RobbeDierickx/GIP-kruispunt-/Gip tussentijdse voorstelling.pptx

## Gip: stand van zaken

Door: Robbe dierickx

## Doel

- Een werkend kruispunt met een hardwareoplossing, lusdetectie en voetgangersknoppen

## Planning

- Bestellen van de printplaat
- Solderen van de printplaat
- Programmeren van de voetgangersknop
- Programmeren van de lichten
- Programmeren van de lusdetectie

## Milestones

- Lusdetectie Deadline: 16/11/2018 Gehaald
- Vertragingsschema Deadline: 20/11/2018 Gehaald
- Hardware lichtsturing Deadline: 30/11/2018 Gehaald
- Eagle schema en bord Deadline: 11/01/2019 Gehaald

## Al gerealiseerd

- Hardware:
- Lusdetectie
- Vertragingsschema
- Lichtsturing
- Software:
- Frequentieteller

## Blokschema HArdware

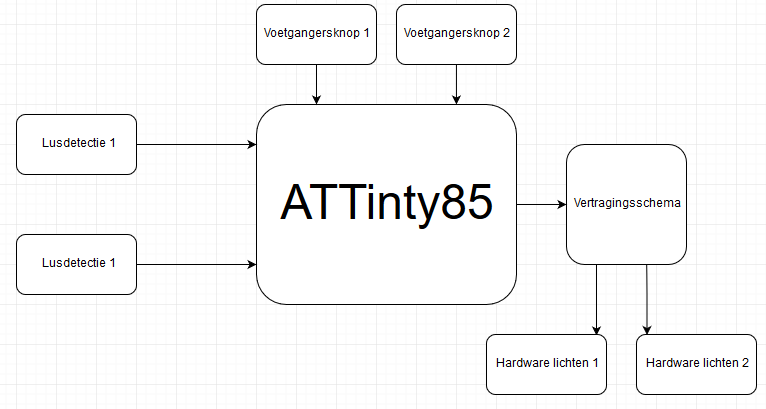
[picture p27: figure]

## Eagle schema’s: Detectielus

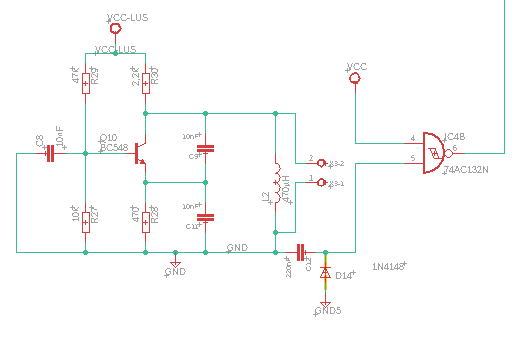
[picture p28: figure]

## Eagle schema’s: Vertragingsschema

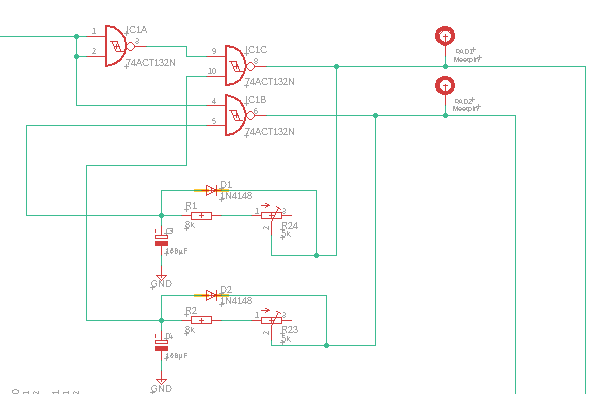
[picture p29: figure]

## Eagle schema’s: Lichtsturing

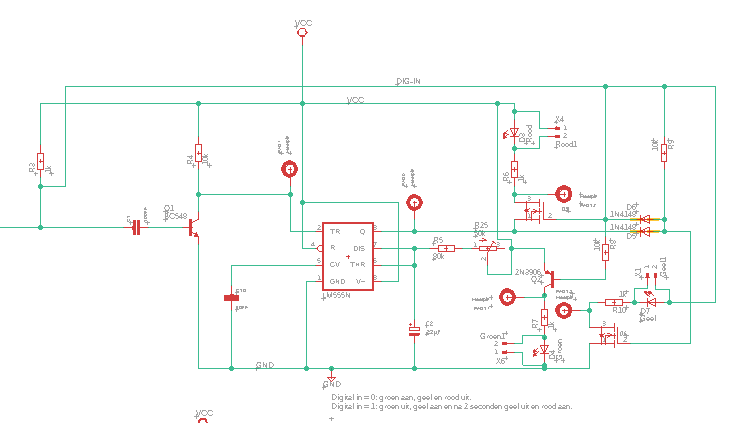
[picture p30: figure]

## Eagle schema’s voeding

Afbeelding met tekst, kaart Beschrijving is gegenereerd met zeer hoge betrouwbaarheid

## Eagle: volledig schema

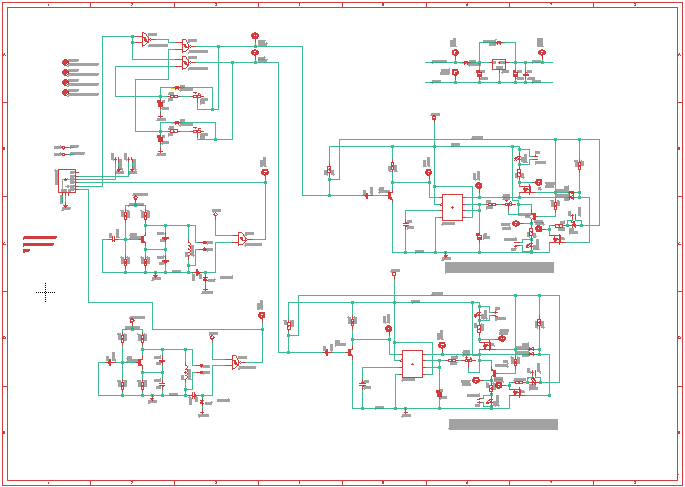
[picture p31: figure]

## Eagle: bord

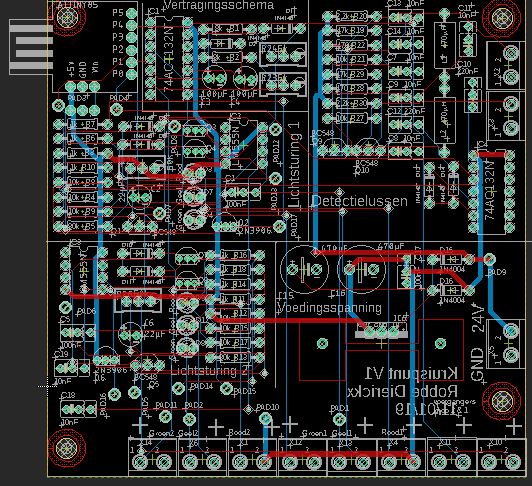
[picture p32: figure]

## Software: flowshart

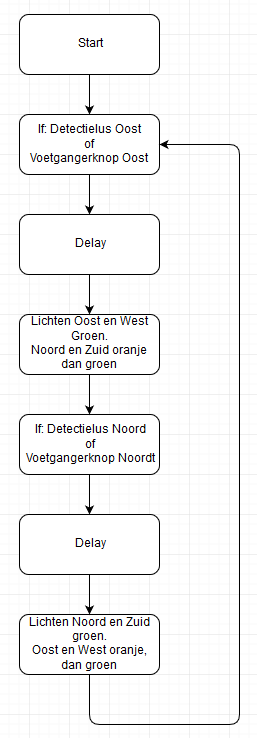
[picture p33: figure]

## Problemen

- ATTiny85: niet genoeg timers om frequentie te meten
- Momentele oplossing: Arduino gebruiken om dan een signaal naar de ATTiny85 te sturen

## Nog te realiseren

- Hardware:
- Printplaat
- Software:
- Lichtsturing
- Voetgangersknoppen

## Conclusies

- Geleerd:
- Lusdetectie
- Wanneer hardware of software te gebruiken
- Eagle te gebruiken
- Verder:
- Printplaat laten maken en hem solderen
- Programmeren van de software (voetgangersknop en lichtsturing)
