RobbeDierickx/GIP-kruispunt-/GIP 6EE Robbe.pptx

## GIP 6EE

Robbe Dierickx

## Wat?

- Automatische regeling van de verkeerslichten op een kruispunt
- Lusdetectie
- Lichtaansturing via hardware
- manuele voetgangersknop

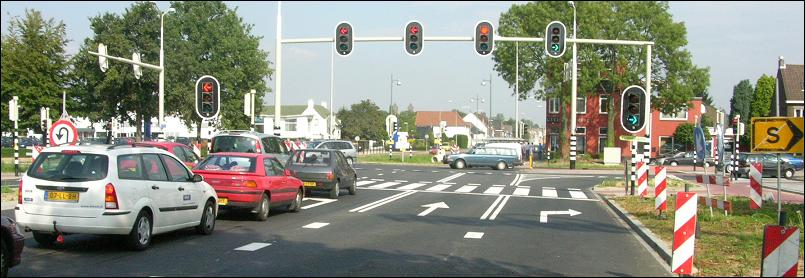
[picture p34: figure]

## Methode

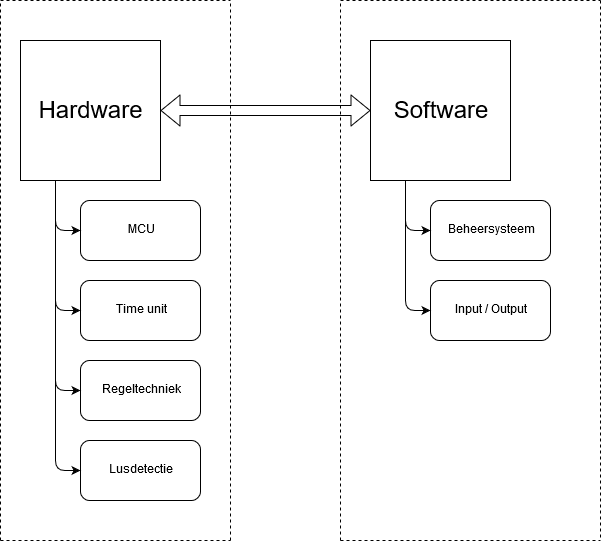
[picture p35: figure]

## Lusdetectie

- Detectie in het wegdek
- voertuig verstoort het magnetische veld Herkend

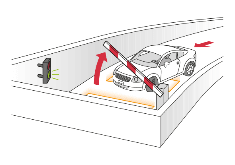
[picture p36: figure]

## MCU

- ATtiny85
- Microcontroller

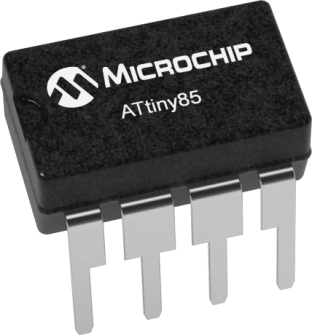
[picture p37: figure]

## Software

- Programmeren met Arduino
- Voetgangersinterface Lichtensturing

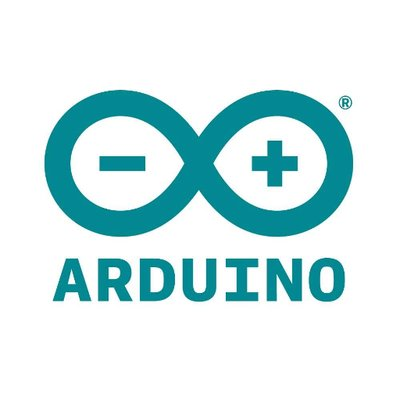
[picture p38: figure]

## Optionele uitbreidingen

- Remote monitoring
- Radar met ultrasoon
- Data doorsturen over Internet Bv: verkeersdrukte
