RobbeDierickx/GIP-kruispunt-/Logboek/Logboek week 21 Robbe Dierickx.docx

# Logboek

## Geïntegreerde Proef

Klas : 6EE

2018-2019

### Technisch adviseur coördinator : M. Van Gucht

Mentor(en) school : E. Arckens

Leerling : Robbe Dierickx

# Logboek

## Geïntegreerde Proef

2018-2019

Naam : Robbe Dierickx

Omschrijving opdracht G.I.P: Kruispunt met behulp van lusdetectie en timers

Betrokken leerkrachten Vak

Mr. E. Arckens Elektriciteit-elektronica

………………………………………………

Mr. E. Arckens Elektriciteit-elektronica

………………………………………………

Schoolweek : 21

Datum | Vak | Omschrijving van de studie, taak of voorbereiding
20/05 | EE | Testen van versie 3 van de printplaat. Aantal gewerkte uren: 2
21/05 | EE | Desolderen en solderen van de definitieve versie van de printplaat. Aantal gewerkte uren: 5
24/05 | EE | Solderen van de nieuwe transistoren + defect component uitzoeken. Aantal gewerkte uren: 2

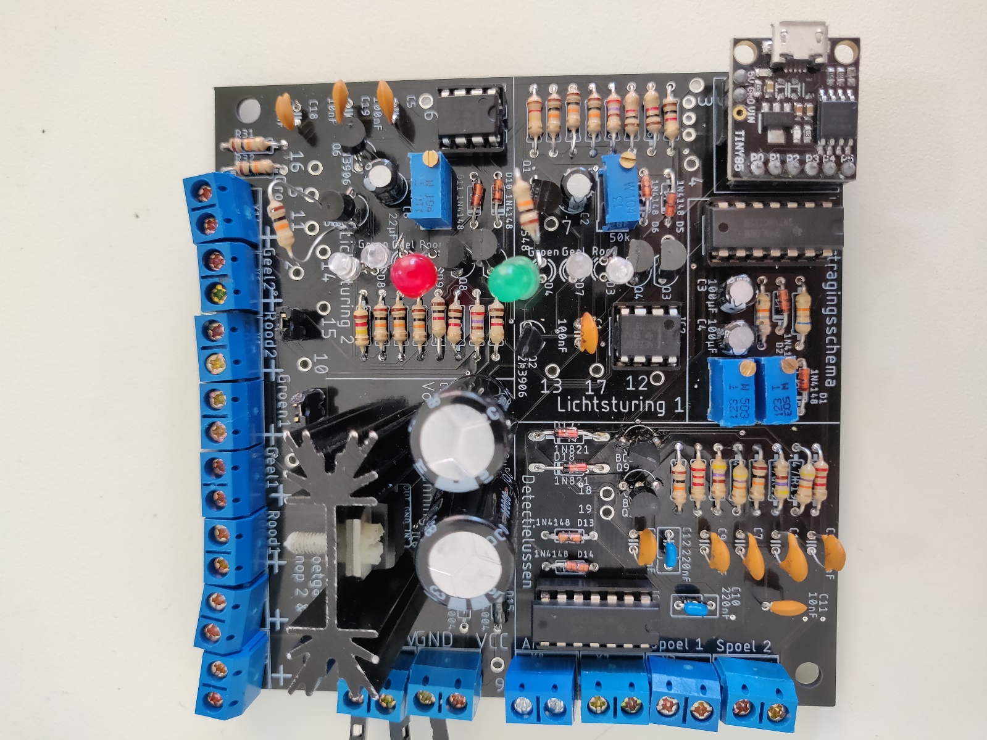
[picture p39: figure]
