RobbeDierickx/GIP-kruispunt-/Logboek/Logboek week 17 Robbe Dierickx.docx

# Logboek

## Geïntegreerde Proef

Klas : 6EE

2018-2019

### Technisch adviseur coördinator : M. Van Gucht

Mentor(en) school : E. Arckens

Leerling : Robbe Dierickx

# Logboek

## Geïntegreerde Proef

2018-2019

Naam : Robbe Dierickx

Omschrijving opdracht G.I.P: Kruispunt met behulp van lusdetectie en timers

Betrokken leerkrachten Vak

Mr. E. Arckens Elektriciteit-elektronica

………………………………………………

Mr. E. Arckens Elektriciteit-elektronica

………………………………………………

Schoolweek : 17

Datum | Vak | Omschrijving van de studie, taak of voorbereiding
23/03 | EE | Maken van versie 3 van de printplaat. Aantal gewerkte uren: 2
25/03 | EE | Afwerken en doorsturen van versie 3 van de printplaat. Aantal gewerkte uren: 2
26/03 | EE | Stijn assisteren met zijn GIP. Aantal gewerkte uren: 3

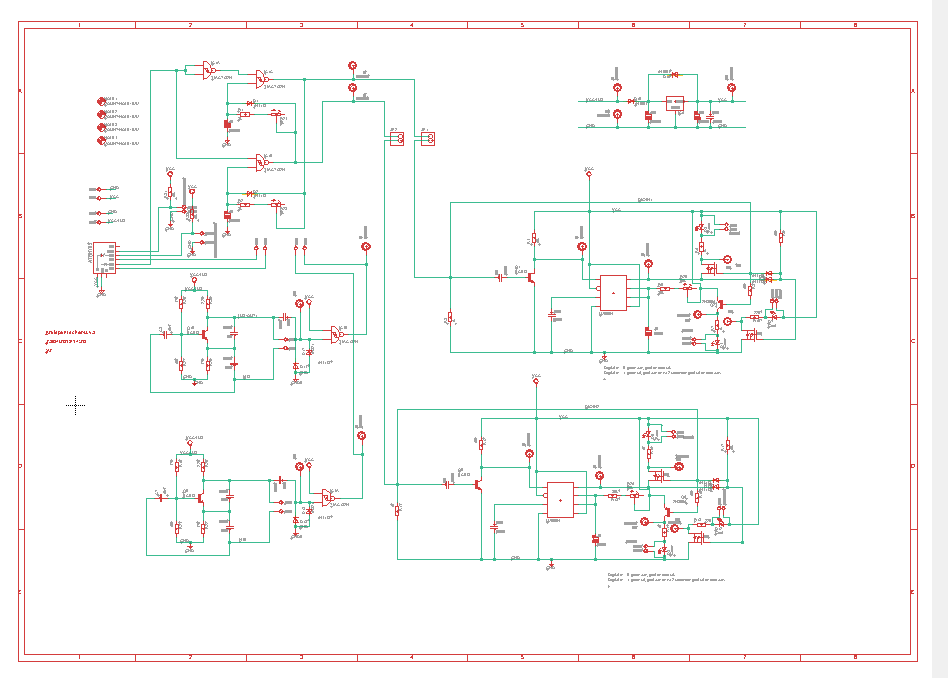
[picture p40: figure]
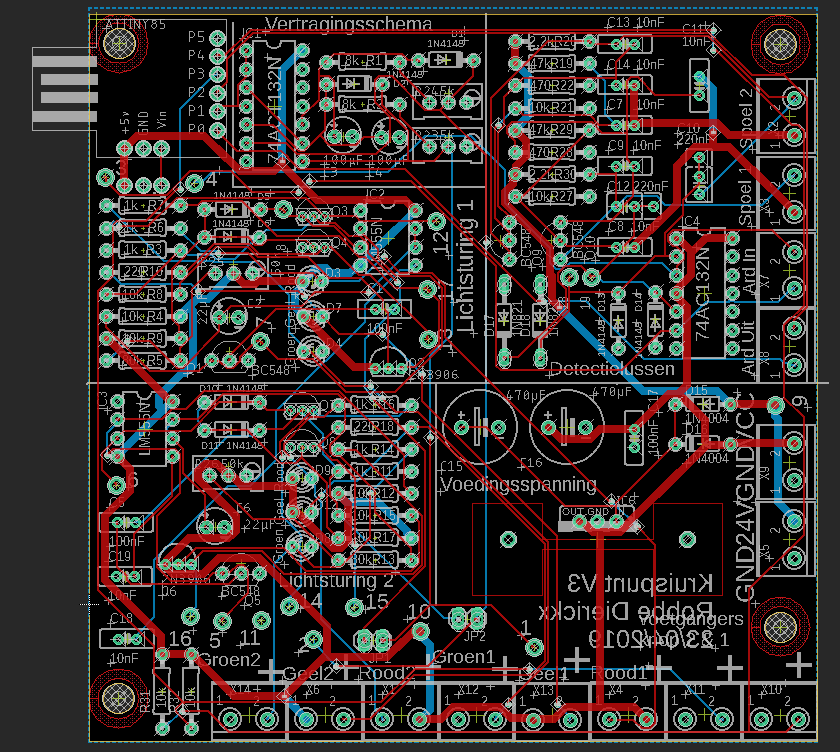
[picture p41: figure]
