RobbeDierickx/GIP-kruispunt-/Logboek/Logboek week 8 Robbe Dierickx.docx

# Logboek

## Geïntegreerde Proef

Klas : 6EE

2018-2019

### Technisch adviseur coördinator : M. Van Gucht

Mentor(en) school : E. Arckens

Leerling : Robbe Dierickx

# Logboek

## Geïntegreerde Proef

2018-2019

Naam : Robbe Dierickx

Omschrijving opdracht G.I.P: Kruispunt met behulp van lusdetectie en timers

Betrokken leerkrachten Vak

Mr. E. Arckens Elektriciteit-elektronica

………………………………………………

Mr. E. Arckens Elektriciteit-elektronica

………………………………………………

Schoolweek : 8

Datum | Vak | Omschrijving van de studie, taak of voorbereiding
19/02 | EE | Verder testen van de colpittsoscillator + testen van het programma: Lusdetectie + versie 2 van de printplaat aanpassen. Aantal gewerkte uren: 3
21/02 | EE | Opstellen van de Demo van de lusdetectie voor de jury + verder aanpassen van Versie 2 van de printplaat. Aantal gewerkte uren: 3
22/02 | | Afwerken van versie 2 van de printplaat en omzetten in gerber files + opzoeken om de frequentie te meten met een ESP8266. Aantal gewerkte uren: 4

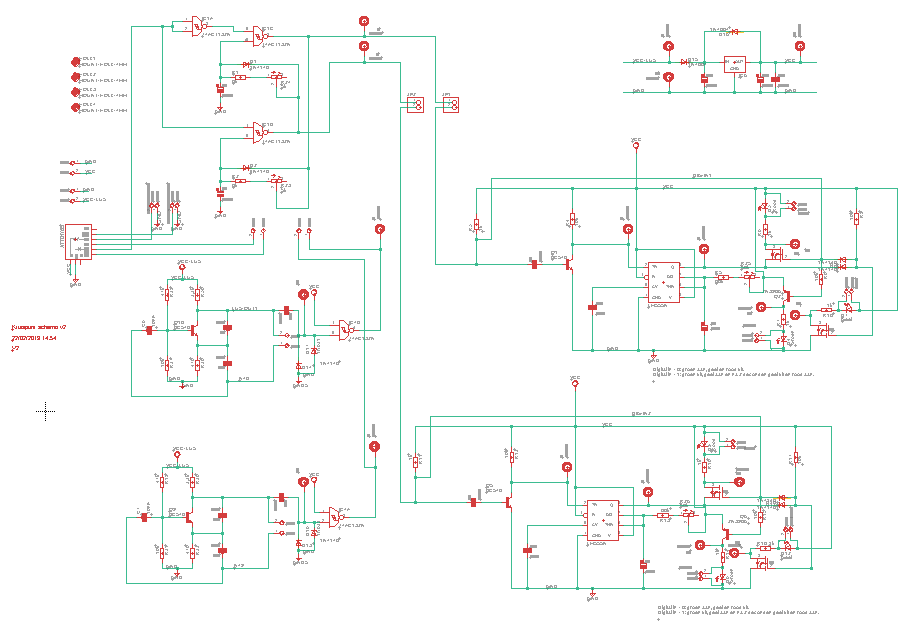
[picture p42: figure]
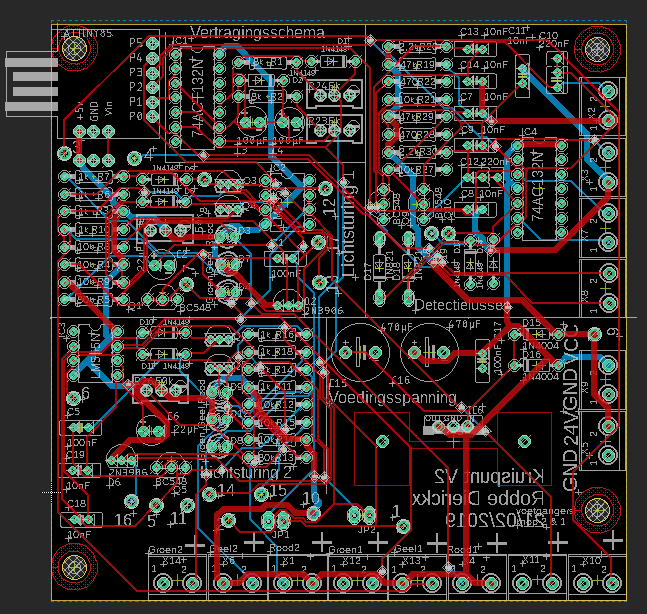
[picture p43: figure]
