RobbeDierickx/GIP-kruispunt-/Logboek/Logboek week 1 & 2 Robbe Dierickx.docx

# Logboek

## Geïntegreerde Proef

Klas : 6EE

2018-2019

### Technisch adviseur coördinator : M. Van Gucht

Mentor(en) school : E. Arckens

Leerling : Robbe Dierickx

# Logboek

## Geïntegreerde Proef

2016-2017

Naam : Robbe Dierickx

Omschrijving opdracht G.I.P: Kruispunt met behulp van lusdetectie en timers

Betrokken leerkrachten Vak

Mr. E. Arckens Elektriciteit-elektronica

………………………………………………

Mr. E. Arckens Elektriciteit-elektronica

………………………………………………

Schoolweek : 1 & 2

Datum | Vak | Omschrijving van de studie, taak of voorbereiding
5/01 | EE | Aanpassen van het schema en bord. Aantal gewerkte uren: 2
11/01 | EE | Verder aanpassen van het schema en bord + exporteren naar een gerber file. Aantal gewerkte uren: 3

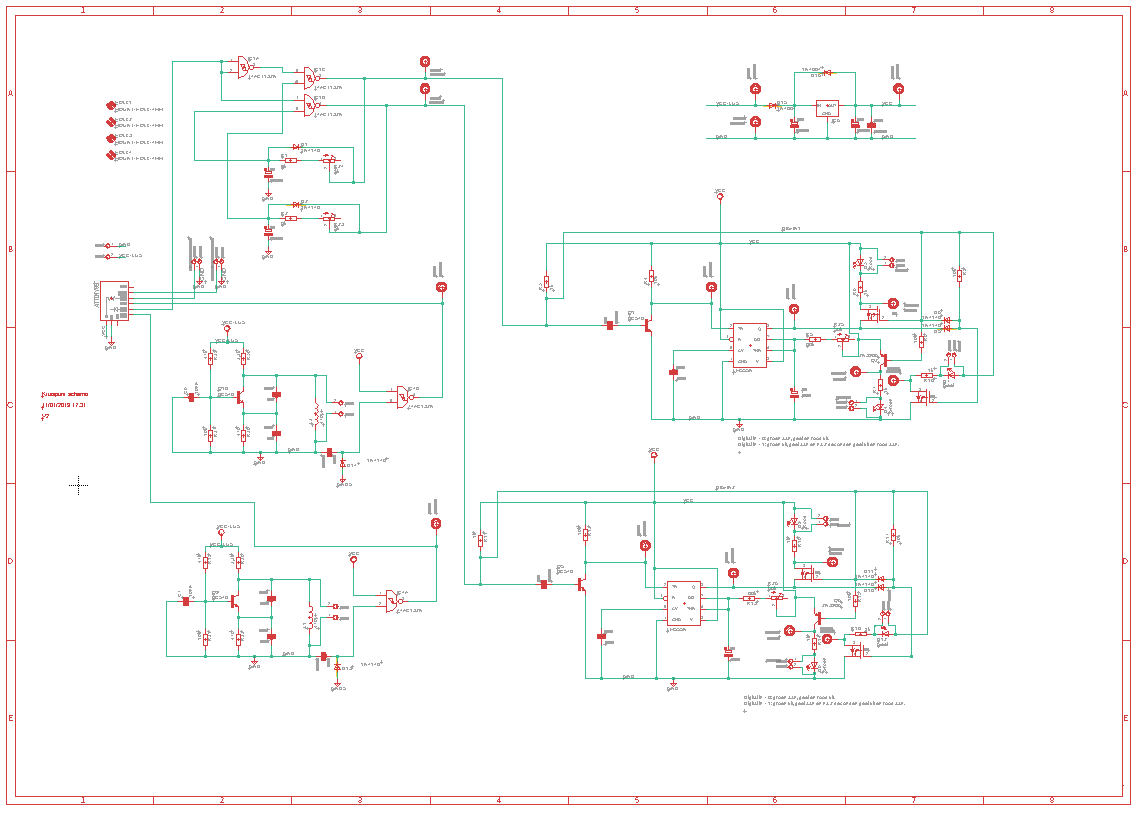
[picture p44: figure]
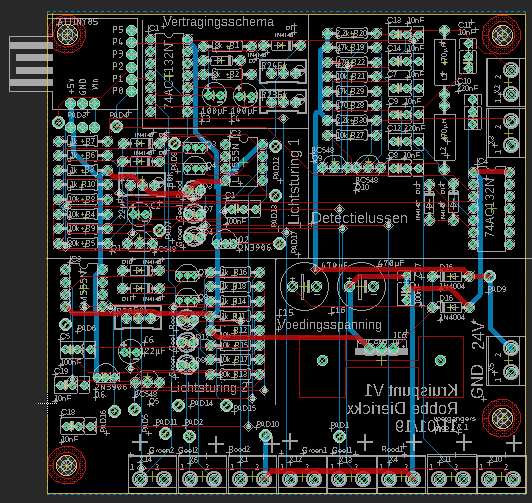
[picture p45: figure]
