RobbeDierickx/GIP-kruispunt-/Kruispunt/Kruispunt schema v3.brd

## EAGLE design Kruispunt/Kruispunt schema v3.brd (2019-04-23)

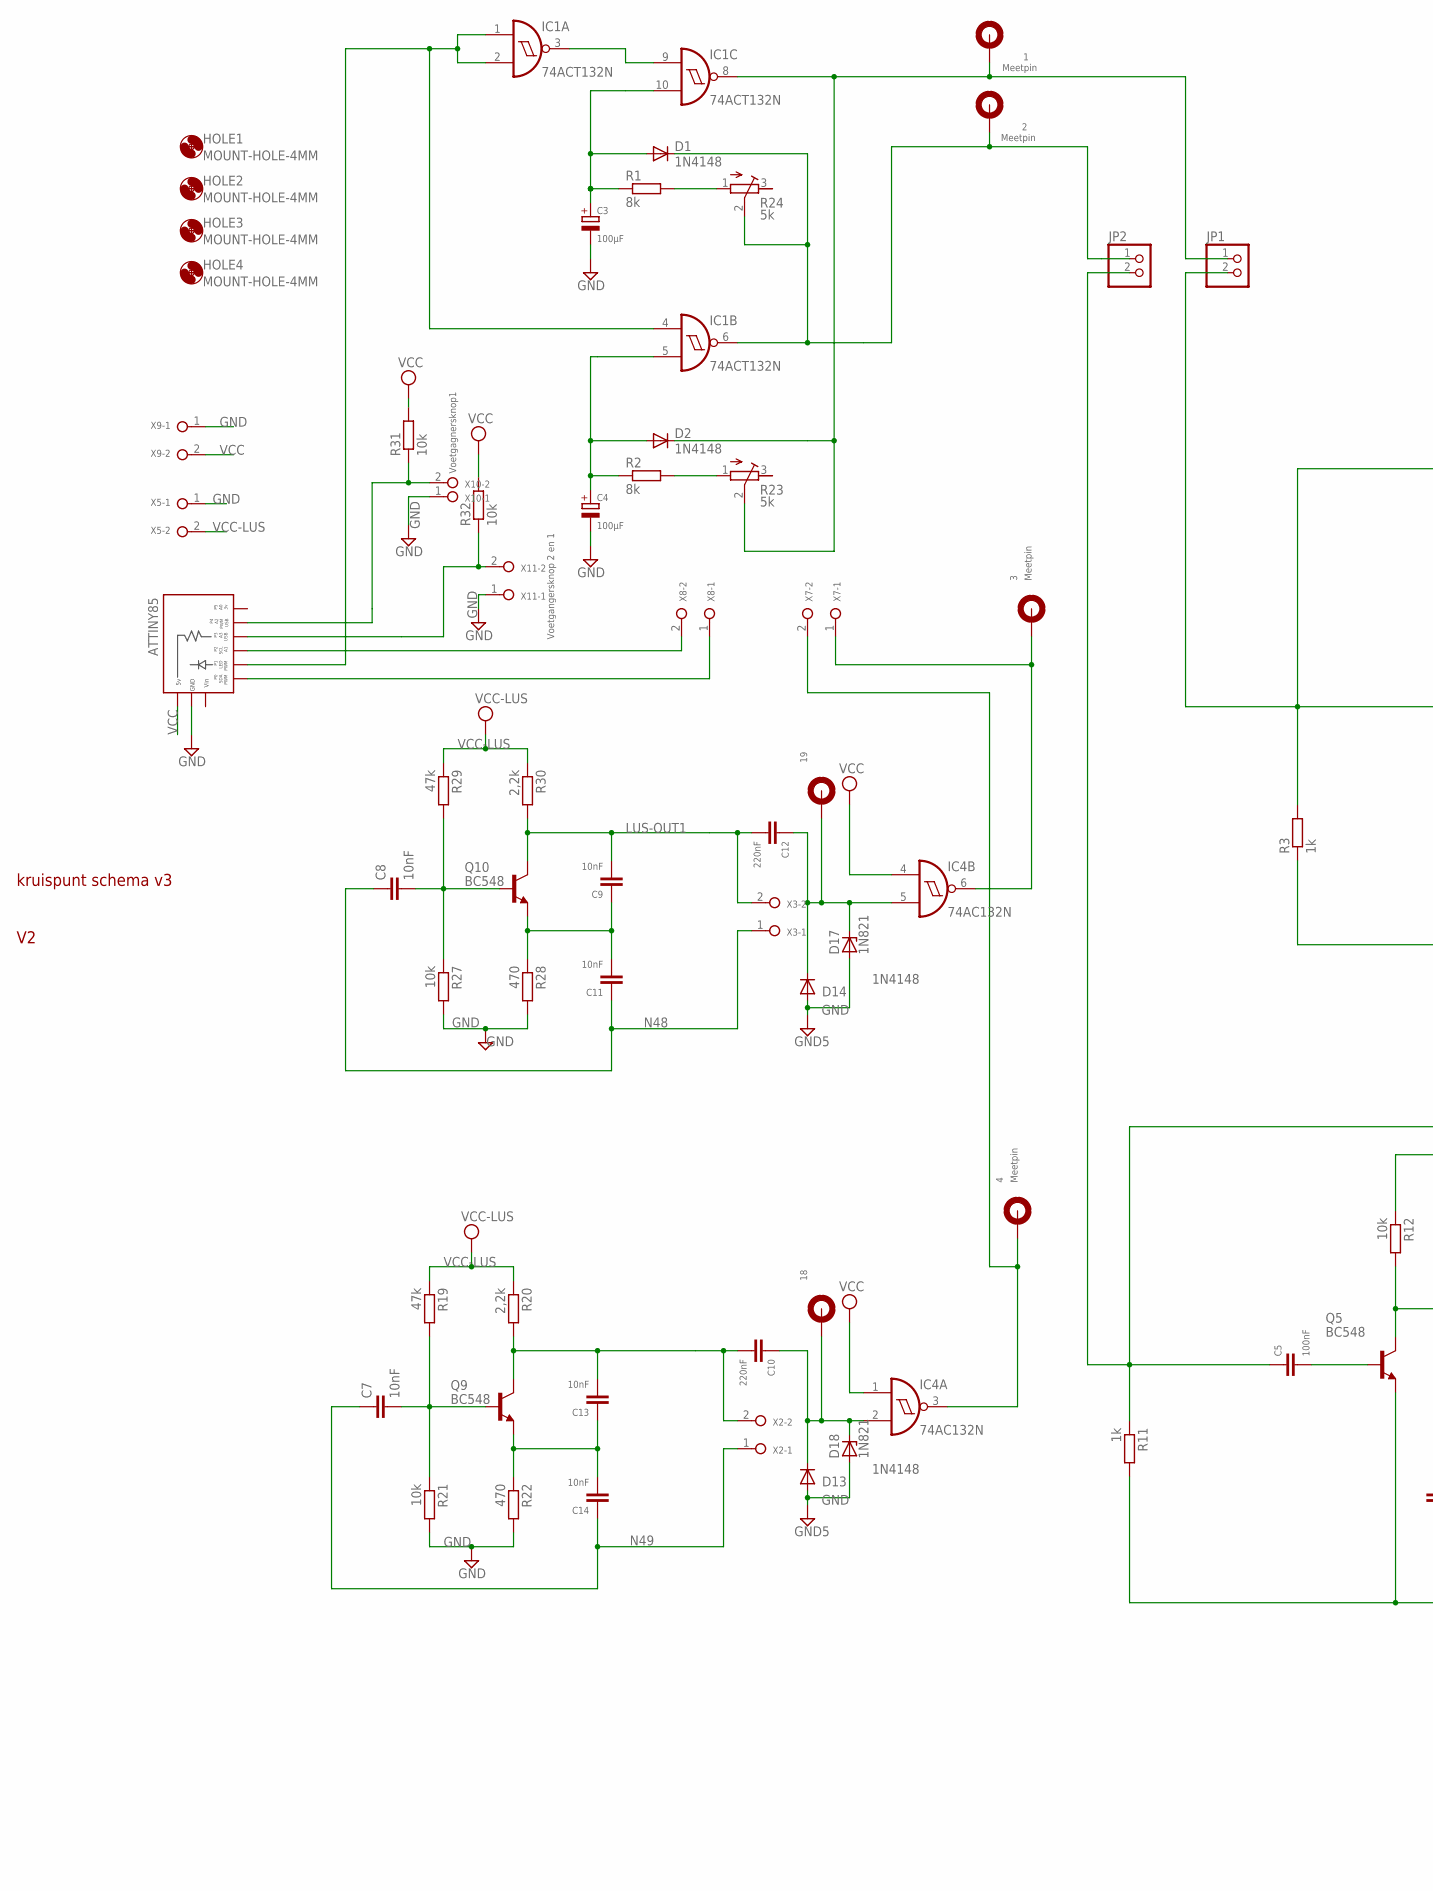
[picture p54: schematic Kruispunt schema v3.sch, part in row 1, column 1]

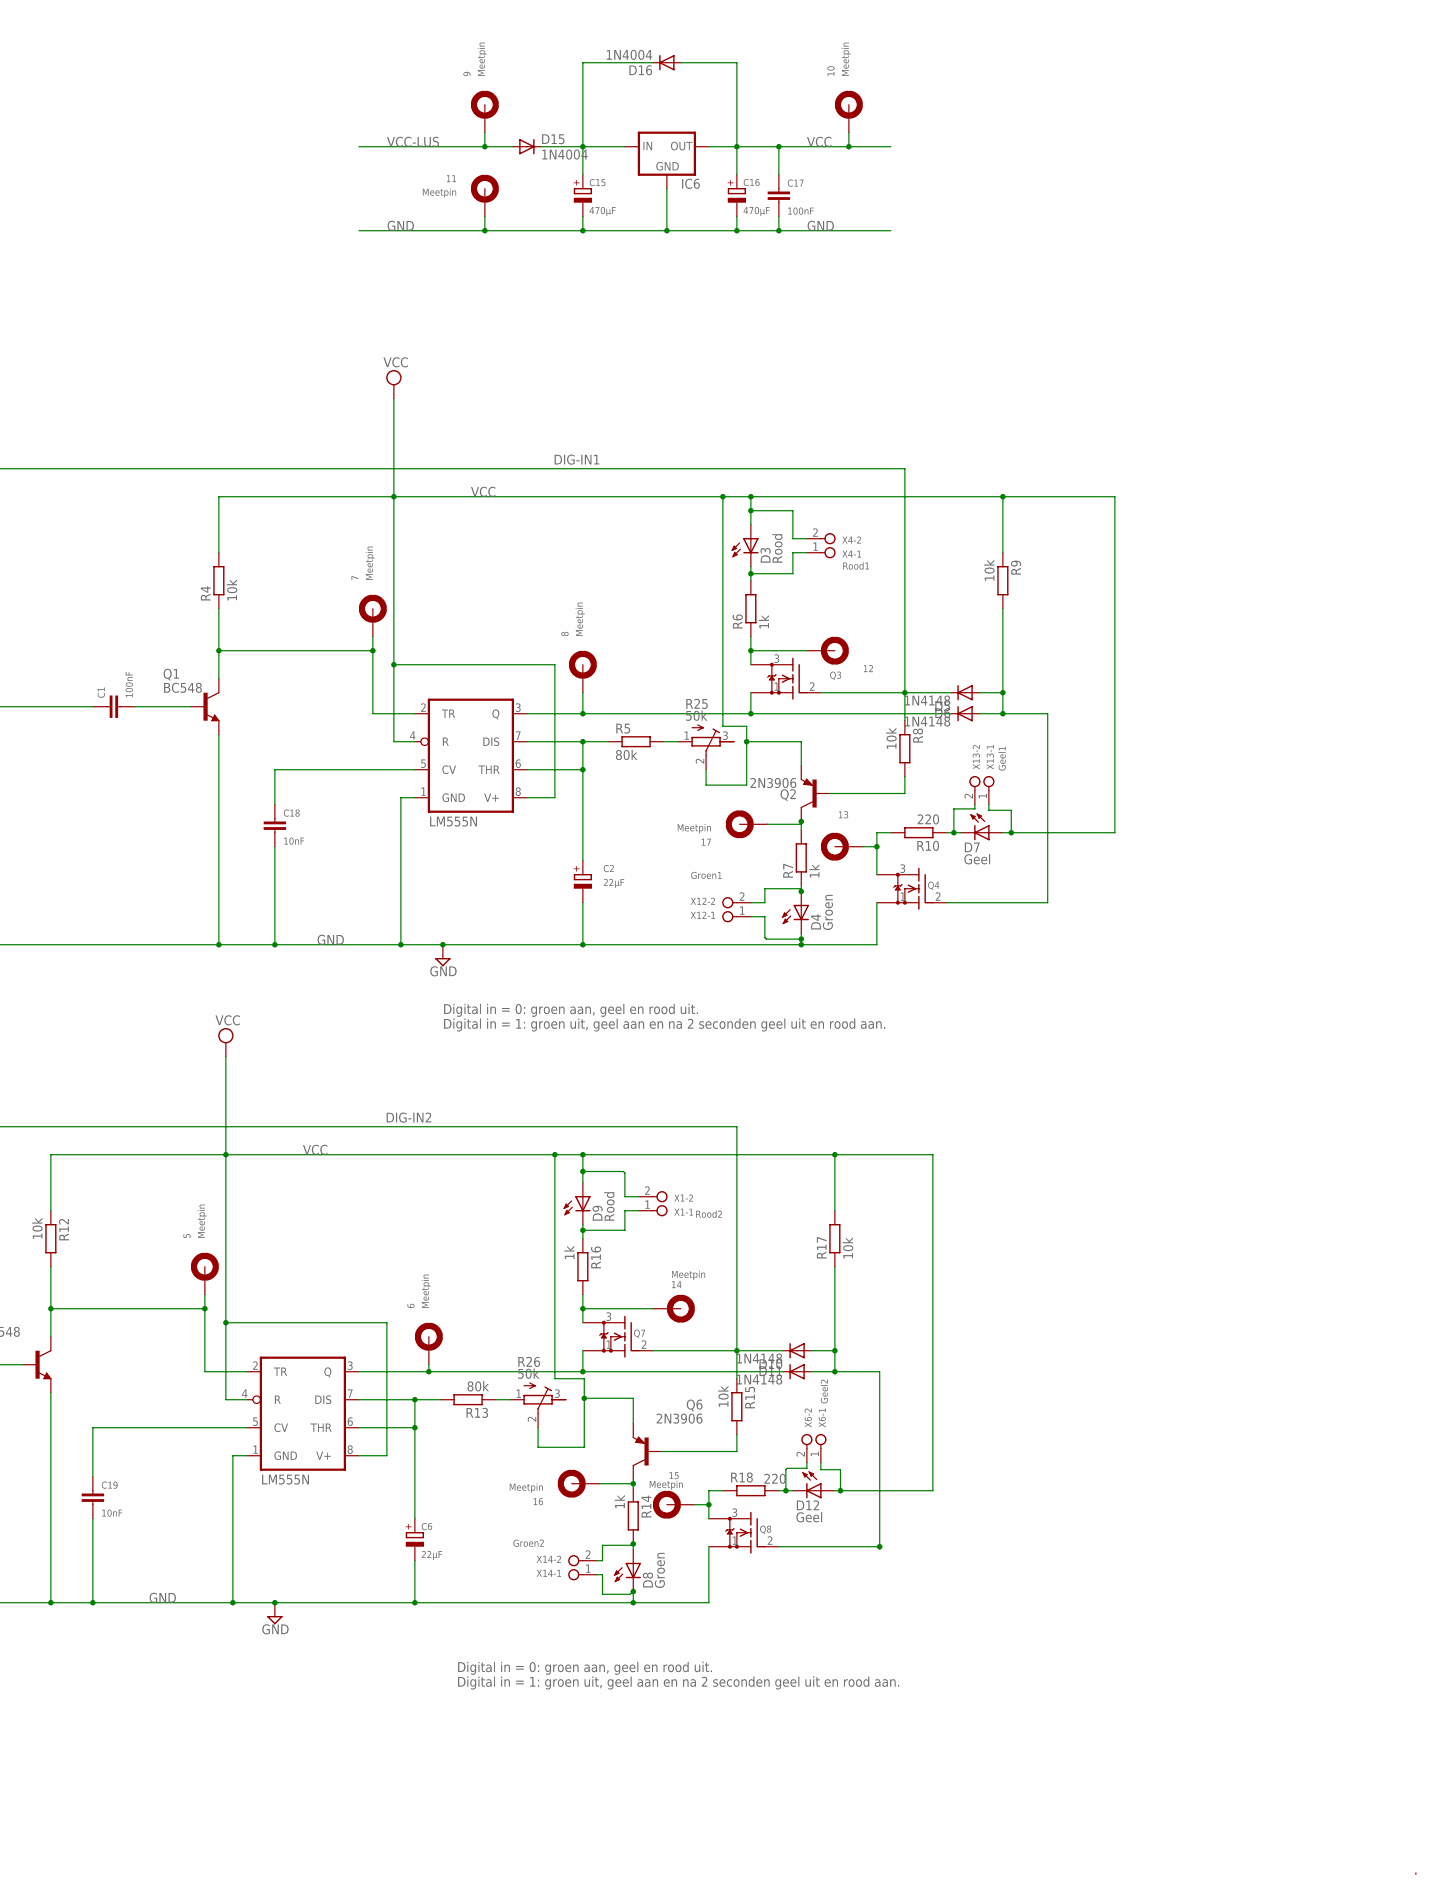
[picture p55: schematic Kruispunt schema v3.sch, part in row 1, column 2]

Parts:
1, 2, 3, 4, 5, 6, 7, 8, 9, 10, 11, 14, 15, 16, 17: Meetpin; PAD
12, 13, 18, 19: WIREPAD; PAD
ATTINY85: DIGISPARK
C1, C5, C17: 100nF; CERAMIC-CAP-C050-025X075
C2, C6: 22µF; ELCO-2.5MMLEAD
C3, C4: 100µF; ELCO-2.5MMLEAD
C7, C8, C9, C11, C13, C14, C18, C19: 10nF; CERAMIC-CAP-C050-025X075
C10, C12: 220nF; CERAMIC-CAP-C025_050-035X075
C15, C16: 470µF; ELCO-5,0MMLEAD
D1, D2, D5, D6, D10, D11, D13, D14: 1N4148; DO35-7
D3, D9: Rood; LED3MM
D4, D8: Groen; LED3MM
D7, D12: Geel; LED3MM
D15, D16: 1N4004; DO35-7
D17, D18: 1N821; DO35Z10
HOLE1, HOLE2, HOLE3, HOLE4: MOUNT-HOLE-4MM; 4,0
IC1: 74ACT132N; DIL14
IC2, IC3: LM555N; DIL08
IC4: 74AC132N; DIL14
IC6: LM78XX-TO220LM78XX-HEATSINK; LM78XX-HEATSINK
JP1, JP2: PINHD-1X2; 1X02
Q1, Q5, Q9, Q10: BC548; TO92-CBE
Q2, Q6: 2N3906; TO92-EBC
Q3, Q4, Q7, Q8: 2N7000; TO-92
R1, R2: 8k; 0207/10
R3, R6, R7, R11, R14, R16: 1k; 0207/10
R4, R8, R9, R12, R15, R17, R21, R27, R31, R32: 10k; 0207/10
R5, R13: 80k; 0207/10
R10, R18: 220; 0207/10
R19, R29: 47k; 0207/10
R20, R30: 2,2k; 0207/10
R22, R28: 470; 0207/10
R23, R24: 5k; RTRIM64W
R25, R26: 50k; RTRIM64W
X1: Rood2; W237-132
X2, X3, X5, X7, X8, X9: TERMINAL-5MM-2POLE; W237-132
X4: Rood1; W237-132
X6: Geel2; W237-132
X10: Voetgagnersknop1; W237-132
X11: Voetgangersknop 2 en 1; W237-132
X12: Groen1; W237-132
X13: Geel1; W237-132
X14: Groen2; W237-132

Connections:
DIG-IN1: C1.P$2, D6.C, JP1.2, Q3.2 (G), R3.2, R8.1
DIG-IN2: C5.P$2, D11.C, JP2.2, Q7.2 (G), R11.1, R15.1
GND: 11.P$1, ATTINY85.GND, ATTINY85.GND1 (GND), C2.-, C3.-, C4.-, C6.-, C15.-, C16.-, C17.P$1, C18.P$1, C19.P$1, D4.K (C), D8.K (C), D13.A, D14.A, D17.A, D18.A, IC1.7 (GND), IC2.1 (GND), IC3.1 (GND), IC4.7 (GND), IC6.GND, Q1.E, Q4.1 (S), Q5.E, Q8.1 (S), R3.1, R11.2, R21.2, R22.2, R27.2, R28.2, X5.1, X9.1, X10.1, X11.1, X12.1, X14.1
LUS-OUT1: C9.P$1, C12.P$1, Q10.C, R30.2, X3.2
N48: C8.P$2, C11.P$2, X3.1
N49: C7.P$2, C14.P$2, X2.1
unnamed: C4.+, D2.A, IC1.5 (I1), R2.1
unnamed: IC1.3 (O), IC1.9 (I0)
unnamed: ATTINY85.P1, IC1.1 (I0), IC1.2 (I1), IC1.4 (I0)
unnamed: C1.P$1, Q1.B
unnamed: R13.1, R26.1 (A)
unnamed: 1.P$1, D2.C, IC1.8 (O), JP1.1, R23.2 (S)
unnamed: C3.+, D1.A, IC1.10 (I1), R1.1
unnamed: 7.P$1, IC2.2 (TR), Q1.C, R4.1
unnamed: C2.+, IC2.6 (THR), IC2.7 (DIS), R5.1
unnamed: 17.P$1, Q2.C, R7.2
unnamed: D4.A, R7.1, X12.2
unnamed: Q2.B, R8.2
unnamed: 12.P$1, Q3.3 (D), R6.1
unnamed: D3.K (C), R6.2, X4.1
unnamed: 8.P$1, D5.C, IC2.3 (Q), Q3.1 (S)
unnamed: R2.2, R23.1 (A)
unnamed: 13.P$1, Q4.3 (D), R10.2
unnamed: D7.K (C), R10.1, X13.2
unnamed: C5.P$1, Q5.B
unnamed: 5.P$1, IC3.2 (TR), Q5.C, R12.2
unnamed: C6.+, IC3.6 (THR), IC3.7 (DIS), R13.2
unnamed: 16.P$1, Q6.C, R14.1
unnamed: D8.A, R14.2, X14.2
unnamed: Q6.B, R15.2
unnamed: 14.P$1, Q7.3 (D), R16.2
unnamed: ATTINY85.P3, R32.1, X11.2
unnamed: 6.P$1, D10.C, IC3.3 (Q), Q7.1 (S)
unnamed: D10.A, D11.A, Q8.2 (G), R17.1
unnamed: 15.P$1, Q8.3 (D), R18.1
unnamed: D12.K (C), R18.2, X6.2
unnamed: C7.P$1, Q9.B, R19.2, R21.1
unnamed: C13.P$2, C14.P$1, Q9.E, R22.1
unnamed: C10.P$1, C13.P$1, Q9.C, R20.2, X2.2
unnamed: 18.P$1, C10.P$2, C10.P$3, D13.C, D18.C, IC4.2 (I1)
unnamed: 4.P$1, IC4.3 (O), X7.2
unnamed: R1.2, R24.1 (A)
unnamed: R5.2, R25.1 (A)
unnamed: C19.P$2, IC3.5 (CV)
unnamed: C8.P$1, Q10.B, R27.1, R29.2
unnamed: C9.P$2, C11.P$1, Q10.E, R28.1
unnamed: D5.A, D6.A, Q4.2 (G), R9.2
unnamed: 19.P$1, C12.P$2, C12.P$3, D14.C, D17.C, IC4.5 (I1)
unnamed: C18.P$2, IC2.5 (CV)
unnamed: 3.P$1, IC4.6 (O), X7.1
unnamed: C15.+, D15.C, D16.C, IC6.IN
unnamed: 2.P$1, D1.C, IC1.6 (O), JP2.1, R24.2 (S)
unnamed: ATTINY85.P2, X8.2
unnamed: D9.K (C), R16.1, X1.1
unnamed: ATTINY85.P0, X8.1
unnamed: ATTINY85.P4, R31.1, X10.2
VCC: 10.P$1, ATTINY85.5V, ATTINY85.5V1 (5V), C16.+, C17.P$2, D3.A, D7.A, D9.A, D12.A, D16.A, IC1.14 (VCC), IC2.4 (R), IC2.8 (V+), IC3.4 (R), IC3.8 (V+), IC4.1 (I0), IC4.4 (I0), IC4.14 (VCC), IC6.OUT, Q2.E, Q6.E, R4.2, R9.1, R12.1, R17.2, R25.2 (S), R26.2 (S), R31.2, R32.2, X1.2, X4.2, X6.1, X9.2, X13.1
VCC-LUS: 9.P$1, D15.A, R19.1, R20.1, R29.1, R30.1, X5.2
VIN: ATTINY85.VIN, ATTINY85.VIN1 (VIN)

Notes on the sheet:
Digital in = 0: groen aan, geel en rood uit. Digital in = 1: groen uit, geel aan en na 2 seconden geel uit en rood aan.

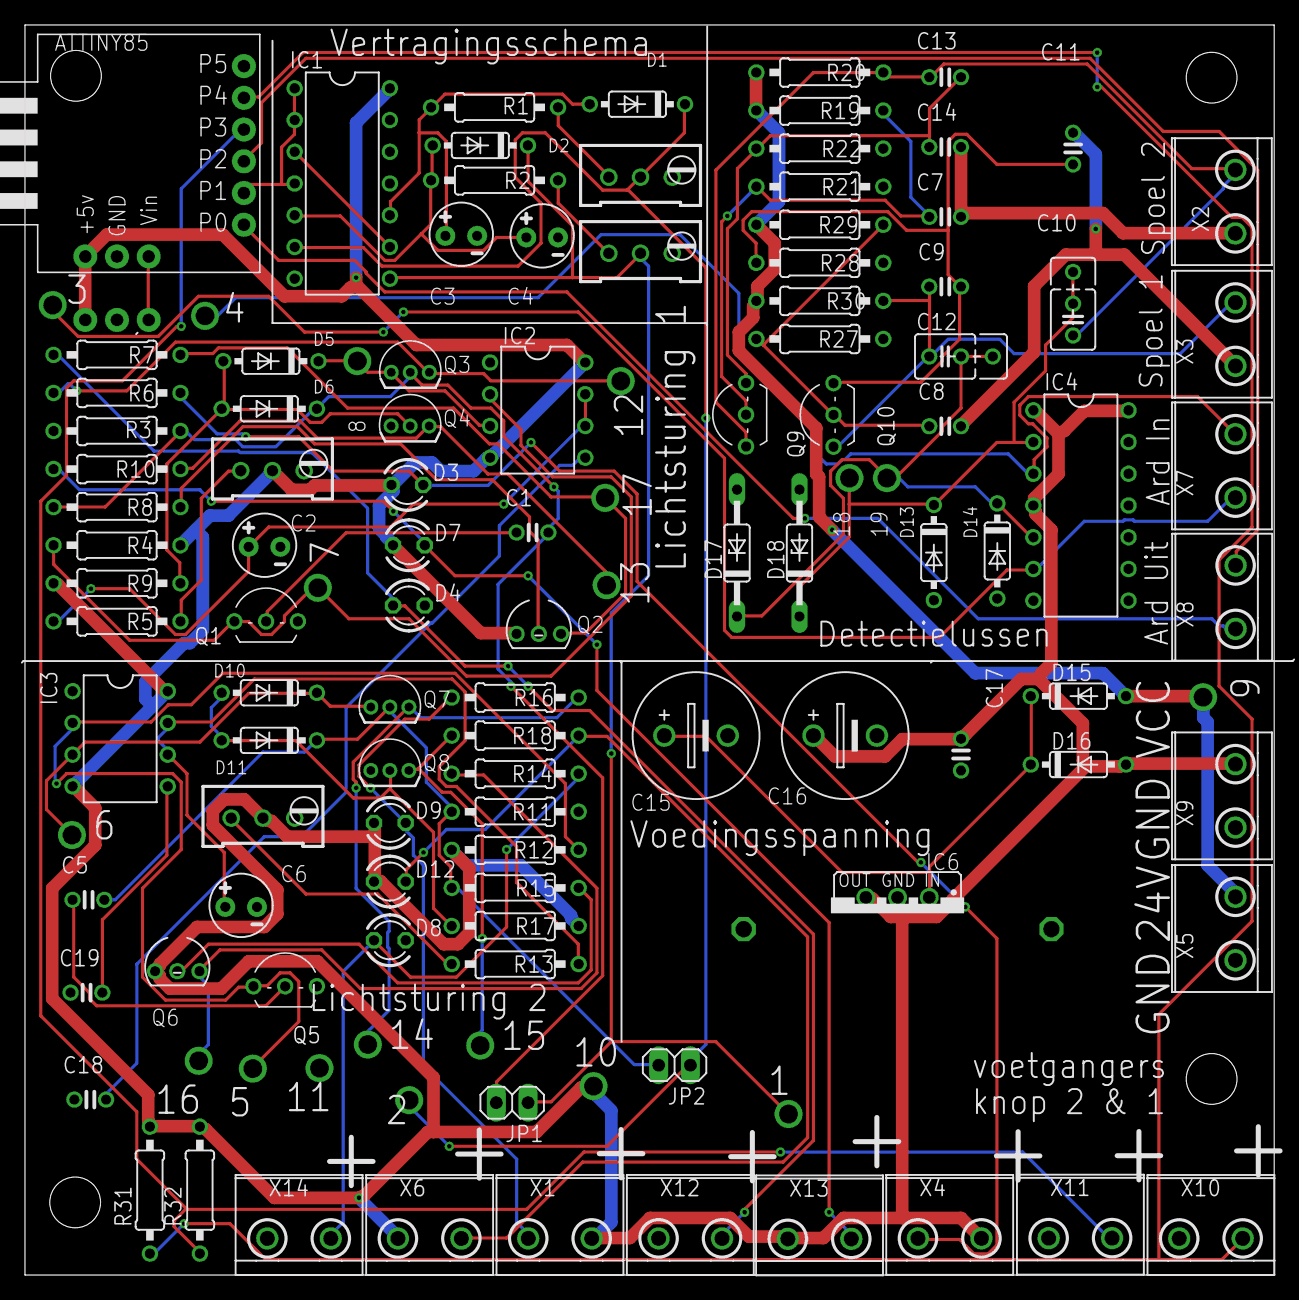
[picture p56: board Kruispunt schema v3.brd from above]

Board: 2 copper layers, 100.0 x 100.1 mm, 124 parts (0 on the bottom side), 59 nets.
