RobbeDierickx/GIP-kruispunt-/Detectielus/Detectielus schema.brd

## EAGLE design Detectielus/Detectielus schema.brd (2018-11-15)

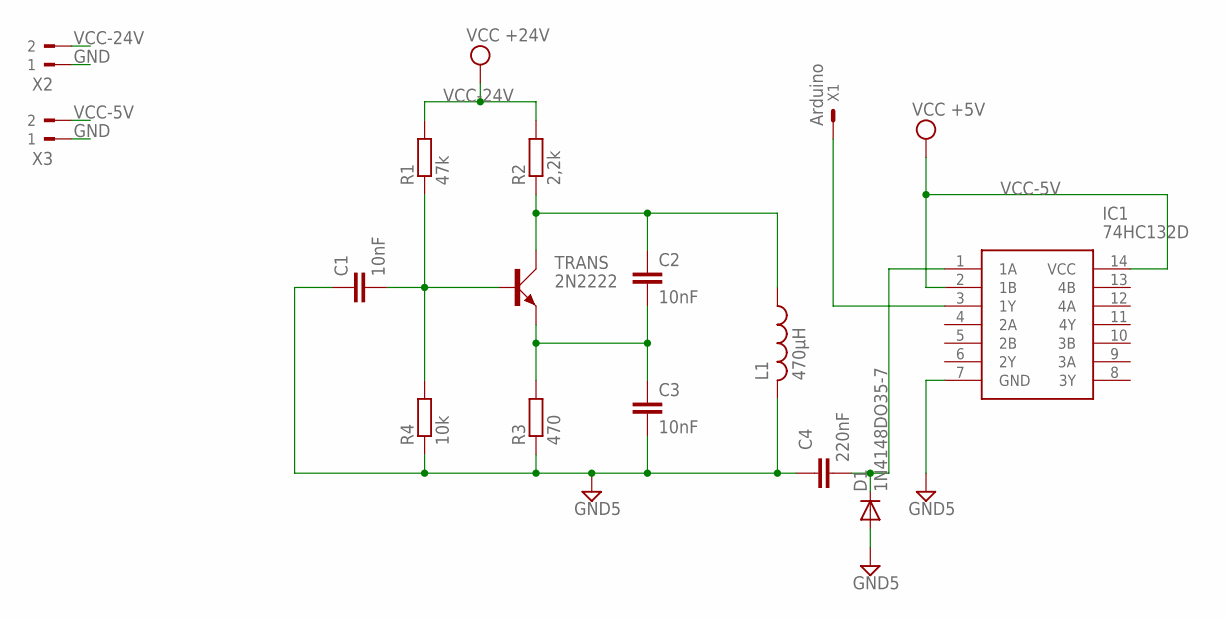
[picture p57: schematic Detectielus schema.sch]

Parts:
C1, C2, C3: 10nF; C050-024X044
C4: 220nF; C050-024X044
D1: 1N4148DO35-7; DO35-7
IC1: 74HC132D; SOIC127P600X175-14N
L1: 470µH; IR-4
R1: 47k; RDH/15
R2: 2,2k; RDH/15
R3: 470; RDH/15
R4: 10k; RDH/15
TRANS: 2N2222; TO220AV
X1: Arduino; 332-02
X2, X3: 90-2

Connections:
GND: X2.1, X3.1
GND5: C1.1, C3.2, C4.1, D1.A, IC1.7 (GND), L1.2, R3.1, R4.1
unnamed: C4.2, D1.C, IC1.1 (1A)
unnamed: C1.2, R1.1, R4.2, TRANS.B
unnamed: C2.2, C3.1, R3.2, TRANS.E
unnamed: C2.1, L1.1, R2.1, TRANS.C
unnamed: IC1.3 (1Y), X1.1
VCC-5V: IC1.2 (1B), IC1.14 (VCC), X3.2
VCC-24V: R1.2, R2.2, X2.2

Board: 2 copper layers, 15 parts (0 on the bottom side), 9 nets, no tracks yet.
