RobbeDierickx/GIP-kruispunt-/(commit log)

2018-11-12 Detectielus Eagle schema
    [Detectielus schema.sch]
2018-11-15 Aanpassing schema (diode)
    [Detectielus schema.sch]
2018-11-15 Schema's en logboek
    [Detectielus schema.brd, Detectielus schema.sch]
2018-11-16 Schema lichtsturing + logboek
    [Hardware lichtsturing schema.sch]
2018-11-26 Schema lichtsturing, library eindbord, Logboek
    [Hardware lichtsturing schema.sch]
2018-11-30 Bord kruispunt + library aanpassing + logboek
    [Kruispunt schema.brd, Kruispunt schema.sch]
2018-12-03 Bord en schema + logboek
    [Kruispunt schema.brd, Kruispunt schema.sch]
2018-12-04 Schema + logboek
    [Kruispunt schema.brd, Kruispunt schema.sch]
2018-12-04 logboek en schema
    [Kruispunt schema.brd, Kruispunt schema.sch]
2019-01-10 Schema en ppt
    [Kruispunt schema.brd, Kruispunt schema.sch]
2019-01-11 Schema, gerber, logboek
    [Kruispunt schema.GBL, Kruispunt schema.GBO, Kruispunt schema.GBP, Kruispunt schema.GBS, Kruispunt schema.GTL, Kruispunt schema.GTO, Kruispunt schema.GTP, Kruispunt schema.GTS]
2019-01-18 kruipunt logboek
    [Kruispunt schema.GBL, Kruispunt schema.GBO, Kruispunt schema.GBP, Kruispunt schema.GBS, Kruispunt schema.GTL, Kruispunt schema.GTO, Kruispunt schema.GTP, Kruispunt schema.GTS]
2019-02-12 schema v2
    [Kruispunt schema v2.brd, Kruispunt schema v2.sch]
2019-04-23 v3 gerber verslag
    [Kruispunt schema v3.brd]
